har-in-air/STM32F411_USB_AUDIO_DAC/docs/dac_pcm5102a.png

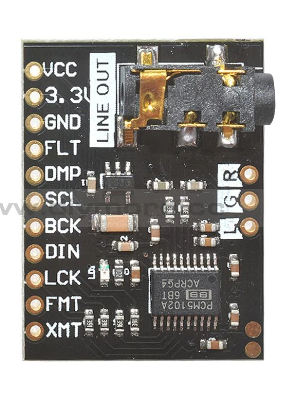
docs/dac_pcm5102a.png
