har-in-air/STM32F411_USB_AUDIO_DAC/docs/dac_uda1334ats.png

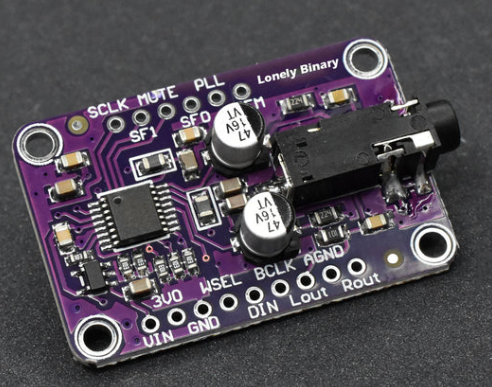
docs/dac_uda1334ats.png
