har-in-air/STM32F411_USB_AUDIO_DAC/(threads)

Thread 1 (2021-01-23):

Shematic BlackPill STM32F411 to PCM5102 Module

kloker2, 2021-01-23:
**BlackPill-F411         PCM5102 Module**
+5v                         VCC
NC                          3.3V
GND              |-       GND
GND              |-        FLT
GND              |-       DMP
GND              |-       SCL	I2Sx_MCK_PIN  (Master Clock)
B13 I2Sx_SCK_PIN  BCK	Тактовый сигнал битовой синхронизации (CLK)Bit clock or serial clock
B15 I2Sx_SD_PIN    DIN	Сигнал данных, который может передавать или принимать 2 разделённых по времени канала. (SD)
B12 I2Sx_WS_PIN   LCK	Тактовый сигнал фреймовой (по словам) синхронизации (WS word select)
GND              |-      FMT
B8  MUTE_PIN       XMT	Mute Software
_________________________________________
A6	I2Sx_MCK_PIN	NC (Master Clock)
_________________________________________
**Board Leds**
B3    LED_RED          // 96000
B6    LED_GREEN     // 48000
B9    LED_BLUE        // 44100

har-in-air, 2021-01-25:
Have updated the pinout in the README, thanks

Closed 2021-01-25.

Thread 2 (2021-05-02):

Error in interrupt table for STM32F411

robcazzaro, 2021-05-02:
First of all, thanks for sharing this. Really helpful

I ported your code to the Windows version of STM32IDE, and I noticed that every time I pushed the Black Pill KEY button, the code would hang in the following section of startup_stm32f411ceux.s

```
    .section  .text.Default_Handler,"ax",%progbits
Default_Handler:
Infinite_Loop:
  b  Infinite_Loop
  .size  Default_Handler, .-Default_Handler
```

I fixed the problem by making two changes in stm32f4xx_it.c

from

```
void EXTI1_IRQHandler(void)
{
  HAL_GPIO_EXTI_IRQHandler(GPIO_PIN_1);
}
```

to

```
void EXTI0_IRQHandler(void)
{
  HAL_GPIO_EXTI_IRQHandler(GPIO_PIN_0);
}
```

It looks like at some point, you changed the interrupt you used and the pin to trigger it, so the code was jumping to a non-existent IRQ service routine and trapped in the infinite loop handler

I would also suggest adding the following to the hardware connections, to explain how to generate the debug print in the USART2 output

```
A2                         TX       Serial debug
A3                         RX
GND                        GND
--------------------------------------------------------------------
To trigger debug printout (if enabled with DEBUG_FEEDBACK_ENDPOINT). press the KEY button on the Black Pill
```

[Not sure if it repros also with the STM32F401 project, I only compiled for STM32F411, but I think the same would happen for the STM32F401, too]

har-in-air, 2021-05-02:
Thanks, fix works on F401CCU6 board.

Closed 2021-05-02.

Thread 3 (2021-05-05):

Difficulty getting Make to compile

Jaron123, 2021-05-05:
Hello,

When trying to build the project I get:
"

make all
arm-none-eabi-gcc -c -mcpu=cortex-m4 -mthumb -mfpu=fpv4-sp-d16 -mfloat-abi=hard -DUSE_HAL_DRIVER -DUSE_FULL_ASSERT -DSTM32F401xC  -DDEBUG_FEEDBACK_ENDPOINT  -Iinc -Idrivers/STM32F4xx_HAL_Driver/Inc -Idrivers/STM32F4xx_HAL_Driver/Inc/Legacy -Istm32_usb/Core/Inc -Istm32_usb/Class/AUDIO/Inc -Idrivers/CMSIS/Device/ST/STM32F4xx/Include -Idrivers/CMSIS/Include -Idrivers/BSP -O2 -Wall -fdata-sections -ffunction-sections -MMD -MP -MF"build/main.d" -Wa,-a,-ad,-alms=build/main.lst src/main.c -o build/main.o
c:/st/stm32cubeide_1.6.0/stm32cubeide/plugins/com.st.stm32cube.ide.mcu.externaltools.make.win32_1.5.0.202011040924/tools/bin/sh: arm-none-eabi-gcc: not found
make: *** [Makefile:180: build/main.o] Error 127
"make all" terminated with exit code 2. Build might be incomplete.

"
I'm new to makefiles and compiling with STM32CubeIDE but so this might be inexperience but I'm at a loss of what to do.
Am I missing something? Is the project still ready to build?

har-in-air, 2021-05-05:
In the makefile, since GCC_PATH is not defined for you,  set GCC_PATH to the full windows path to the ST gcc compiler binary. Or you could add the path to the binary to your windows environment variable PATH.
    On Wednesday, 5 May, 2021, 03:05:02 pm IST, Jaron123 ***@***.***> wrote:

Hello,

When trying to build the project I get:
"

make all
arm-none-eabi-gcc -c -mcpu=cortex-m4 -mthumb -mfpu=fpv4-sp-d16 -mfloat-abi=hard -DUSE_HAL_DRIVER -DUSE_FULL_ASSERT -DSTM32F401xC -DDEBUG_FEEDBACK_ENDPOINT -Iinc -Idrivers/STM32F4xx_HAL_Driver/Inc -Idrivers/STM32F4xx_HAL_Driver/Inc/Legacy -Istm32_usb/Core/Inc -Istm32_usb/Class/AUDIO/Inc -Idrivers/CMSIS/Device/ST/STM32F4xx/Include -Idrivers/CMSIS/Include -Idrivers/BSP -O2 -Wall -fdata-sections -ffunction-sections -MMD -MP -MF"build/main.d" -Wa,-a,-ad,-alms=build/main.lst src/main.c -o build/main.o
c:/st/stm32cubeide_1.6.0/stm32cubeide/plugins/com.st.stm32cube.ide.mcu.externaltools.make.win32_1.5.0.202011040924/tools/bin/sh: arm-none-eabi-gcc: not found
make: *** [Makefile:180: build/main.o] Error 127
"make all" terminated with exit code 2. Build might be incomplete.

"
I'm new to makefiles and compiling with STM32CubeIDE but so this might be inexperience but I'm at a loss of what to do.
Am I missing something? Is the project still ready to build?

—
You are receiving this because you are subscribed to this thread.
Reply to this email directly, view it on GitHub, or unsubscribe.

Jaron123, 2021-05-06:
Thanks Hair in air!
If anyone has the same problem I copy and pasted the PATH variables (Project-properties-Enviroment) from another project into this one and that seemed to work.

FAUSTINOCRUZELIS, 2022-09-14:
> Thanks Hair in air! If anyone has the same problem I copy and pasted the PATH variables (Project-properties-Enviroment) from another project into this one and that seemed to work.

hello bro, i didn''t undestand how do you solved it
what software o binaries do you used to compile this on windows (i had to install ubutu and a lot of packets to make it compile jaja)

Closed 2021-05-06.

Thread 4 (2021-05-09):

How Can it use external clock in I2S

Timo-AL, 2021-05-09:
I want to use crystal oscillator as I2S clock source, but it woulden work.

I connect two oscillator to PA2 than connect led pins to enbale pin on oscillato. Also, changing some codes in bsp_audio.c. Than commenting out all the code in usart.c to left PA2 free. But the chip still use 25Mhz crystal as I2S clock source.

Here are codes that what I change.All of then are in bsp_audio.c.
```
const I2S_CLK_CONFIG I2S_Clk_Config24[3]  = {
{429, 4, 8, 0, 0x0B000000}, // 44.0995
{384, 5, 8, 0, 0x0C000000}, // 48.0000
{424, 3, 4, 0, 0x18000000}  // 96.0144
};
#endif
```
```
    if (freqindex != -1)  {
    N = I2S_Clk_Config24[freqindex].N;
    R = I2S_Clk_Config24[freqindex].R;
    I2SDIV = I2S_Clk_Config24[freqindex].I2SDIV;
    ODD = I2S_Clk_Config24[freqindex].ODD;

    RCC_ExCLKInitStruct.PeriphClockSelection** = RCC_I2SCLKSOURCE_EXT;
#ifdef STM32F411xE
    RCC_ExCLKInitStruct.PLLI2S.PLLI2SM = 25;
#endif
    RCC_ExCLKInitStruct.PLLI2S.PLLI2SN = N;
    RCC_ExCLKInitStruct.PLLI2S.PLLI2SR = R;
    HAL_RCCEx_PeriphCLKConfig(&RCC_ExCLKInitStruct);
    I2S_PR = (MCKOE<<9) | (ODD<<8) | I2SDIV;
    I2S_Config_I2SPR(I2S_PR);
    }
  else { // Default PLL I2S configuration for 96000 Hz 24bit
    N = I2S_Clk_Config24[2].N;
    R = I2S_Clk_Config24[2].R;
    I2SDIV = I2S_Clk_Config24[2].I2SDIV;
    ODD = I2S_Clk_Config24[2].ODD;

    RCC_ExCLKInitStruct.PeriphClockSelection = RCC_I2SCLKSOURCE_EXT;
#ifdef STM32F411xE
    RCC_ExCLKInitStruct.PLLI2S.PLLI2SM = 25;
#endif
    RCC_ExCLKInitStruct.PLLI2S.PLLI2SN = N;
    RCC_ExCLKInitStruct.PLLI2S.PLLI2SR = R;
    HAL_RCCEx_PeriphCLKConfig(&RCC_ExCLKInitStruct);
    I2S_PR = (MCKOE<<9) | (ODD<<8) | I2SDIV;
    I2S_Config_I2SPR(I2S_PR);
```
```
static void I2Sx_Init(uint32_t AudioFreq) {
  haudio_i2s.Instance = SPI2;

  __HAL_I2S_DISABLE(&haudio_i2s);

  haudio_i2s.Init.Mode = I2S_MODE_MASTER_TX;
  haudio_i2s.Init.Standard = I2S_STANDARD_PHILIPS;
  haudio_i2s.Init.DataFormat = I2S_DATAFORMAT_24B;
  haudio_i2s.Init.AudioFreq = AudioFreq;
  haudio_i2s.Init.CPOL = I2S_CPOL_LOW;
  haudio_i2s.Init.ClockSource = I2S_CLOCK_EXTERNAL;
#ifdef USE_MCLK_OUT
  haudio_i2s.Init.MCLKOutput = I2S_MCLKOUTPUT_ENABLE;
#endif
  haudio_i2s.Init.FullDuplexMode = I2S_FULLDUPLEXMODE_DISABLE;

  HAL_I2S_Init(&haudio_i2s);
}
```

har-in-air, 2021-05-09:
sorry, no idea how that would work.

Closed 2021-05-09.

Thread 5 (2021-05-14):

Problem with compiling

gotrune, 2021-05-14:
Hello,
I'm on windows with cubeIDE v1.6.1 and I cant compile due to librairies error, i want to try asap if this board is good for me then can you upload a compiled program for the stm32f401CU please?

har-in-air, 2021-05-14:
??!!  What is the library error ? What is "this board" ? You have provided zero information that points to an issue with the repository code that I need to fix.

gotrune, 2021-05-14:
I dont have any link for the library's in the project. It's my first time on CubeIDE.
I think there's no issue with your code, i'm a beginner with cube and i dont want to spend more time on its. My test board is a Blackpill STM32F401CCU6, I just want a compiled file please.
If the project work good for my purpose i'll gop further with the debug....

Closed 2021-05-14.

Thread 6 (2021-05-16):

Help troubleshooting, please

robcazzaro, 2021-05-16:
I'm using a Windows 7 PC connected to a BlackPill STM32F411 with your code running on it. Everything works

From time to time, though. I get the onboard blue LED (PC13) to turn on, flashing rapidly. The code that triggers it is in usb_audio.c, in particular:

```
    // Monitor remaining writable buffer samples with LED
    if (audio_buf_writable_samples < AUDIO_BUF_SAFEZONE_SAMPLES) {
    	BSP_OnboardLED_On();
    	}
    else {
    	BSP_OnboardLED_Off();
    	}
```

I'm trying to understand if that's something I need to worry about and, if so, what can I look at to try and figure out if I did something wrong (I'm compiling on a Windows machine and using a STM32CubeIDE project I created, so there might be some difference with your code)

har-in-air, 2021-05-17:
If the led is flashing on and off regularly and the audio application is not working, it's in the Error_Handler in main.c - which means a fatal fault. I haven't seen that yet, you can try putting a breakpoint in the entry and trace the call leading to the fault.

If the blue led comes on while no audio is streaming, and then immediately goes off when you start streaming audio, no problem.

robcazzaro, 2021-05-17:
Thanks for your reply. I should have mentioned, but I already had a breakpoint in the Error_Handler function, and that never gets triggered.

In my case the blue led turns on and off while streaming. The BSP_OnboardLED_On(0 and BSP_OnboardLED_Off() functions sometimes get called multiple times while streaming, so I can see the LED flickering.

Am I right in understanding that the LED flickering while streaming might indicate a buffer underrun? I wonder if it's a problem with the USB bus on my Windows machine being overloaded and maxing out, since it seems to happen more frequently when the PC is overloaded

har-in-air, 2021-05-18:
Thats possible. Do you have heavy data transfers on USB e.g. external hard drives - that could cause an issue with available bus bandwidth for isochronous transfers. I have two USB hubs attached to my laptop with several HID devices attached,  JTAG adapter for flashing, printer etc.

I have only seen a hiccup in the audio streaming a couple times in several months now.  I do see the onboard led come on and stay on sometimes when no audio is streaming, but it goes off immediately when playback starts.

Closed 2021-05-17.

Thread 7 (2021-05-16):

Are you interested in adding the files to make your project work in STM32CubeIDE on Windows?

robcazzaro, 2021-05-16:
I ported your project to STM32CubeIDE on Windows, and if you are interested, I have included here all the files (for STM32F411, if you also want for the 401 I will need to tweak a couple of things)

[STM32F411UAD.zip](https://github.com/har-in-air/STM32F411_USB_AUDIO_DAC/files/6490113/STM32F411UAD.zip)

har-in-air, 2021-05-17:
Thanks

Closed 2021-05-17.

Thread 8 (2021-05-16):

Feature request: volume control

robcazzaro, 2021-05-16:
I really like the code you wrote, and I plan to use it in the future. I'm connecting my STM32F411 BlackPill to a SSM3582 amplifier board that takes I2S input directly and amplifies it (i.e. not just a I2S DAC like the PCM5102a)

Unfortunately, since the amplifier is 30W and has no volume control, without the ability to change the volume, it will always output at the maximum volume. Your code currently only uses volume=0 for mute and volume=100 for full volume, with nothing in between.

Would you consider adding code to actually enable volume control, possibly using some of the ideas in this thread https://www.microchip.com/forums/m932509.aspx?

har-in-air, 2021-05-17:
Thanks, an additional control endpoint for volume is possible but no promises as to when and if I will implement this.
I just use the host application volume control.

In another project where I use a TAS5753 I2S amplifier, it has an I2C configuration & control interface  with volume and mute control, and I use a rotary encoder for volume control.
If you're talkiing about a similar interface but where I manually scale the I2S data using a button or encoder interface,  that's not something I personally want to add to this project as I prefer  a minimalistic USB-I2S dongle.

har-in-air, 2021-05-17:
BTW, the SSM3582 has an I2C interface, you can add the volume control feature yourself using my STM32F407 USB Audio + FPGA audiocrossover filter + I2S amplifier project as an example

robcazzaro, 2021-05-18:
Thanks. Unfortunately my SSM board does not expose the I2C connection, and doesn't have a volume control. So my only way to change volume is to use the Windows volume control and have Windows send "scaled down" audio. And for some reason it doesn't do it with your code, but works with other USB devices with no volume control.

I think it is connected to how Windows sees the device capabilities. I basically need Windows to recognize the device and uses the following https://docs.microsoft.com/en-us/windows-hardware/drivers/audio/software-volume-control-support

I'm now trying to understand from the USB audio descriptor is there's anything I can do to have Windows behave properly and send scaled down data

Can you actually change volume from your computer? I assume you are running Linux

har-in-air, 2021-05-18:
Yes, I use Ubuntu - VLC, youtube, web video apps with volume controls all work  fine. Only thing that doesn't is the volume control icon on my desktop title bar :-P.

The host apps should see the device enumerated capabilities and either send a control transfer for volume if supported, or scale the data if not supported, like VLC etc are doing. I guess not all support the data scaling option.

robcazzaro, 2021-05-18:
Thanks for confirming, that's what I thought. Even in your case, it's not working properly: if the system volume control doesn't work, that means that the OS thinks that the device will implement its own volume scaling (either in SW or HW, for example with a I2C volume controller). The apps, on the other hand, scale the output internally, before sending it to the OS pipeline. So, obviously, if an app is reducing the volume, the OS itself sees a lower signal and sends a lower signal to the I2S device.

I finally figured out what was happening. In your code, you declared that the USB device has both a Mute and Volume functionality, but then did not implement the volume control itself, just Mute On if Volume==0, or Mute Off for every other value. So basically, every time you change the OS volume, the OS  simply sends a request to the USB endpoint to use a new volume during playback, but then the code didn't do anything with that request.

So the fix is really trivial, simply tell the OS that the device doesn't have a volume control, by removing the |AUDIO_CONTROL_VOL setting in AUDIO_CONTROL_FEATURES as below (line 48 in usb_audio.c)

```
// Feature Unit Config
#define AUDIO_CONTROL_FEATURES (AUDIO_CONTROL_MUTE )
```

Hardware Mute control in BSP_AUDIO_OUT_SetMute() still works just fine, as well as the HW mute when nothing is playing. On the other hand, BSP_AUDIO_OUT_SetVolume() is never called, so setting the volume to 0 in the OS control will produce no sound (OS scaling the stream to 0), but will not enable the hardware Mute pin. So the only proper way to set a hardware Mute is by using the OS mute functionality

har-in-air, 2021-05-19:
Just removing AUDIO_CONTROL_VOLUME  from AUDIO_CONTROL_FEATURES broke the code (no audio anymore) on my system.

But thanks for pushing this issue, I am working on usb audio mute and volume  control implementation, will update when done.

har-in-air, 2021-05-19:
Implemented USB volume and mute feature. Max volume = 0dB (no amplification), Min volume = -126dB, attenuation steps in 6dB. Now mute and volume control work with VLC as well as Ubuntu desktop volume control. Let me know if you see any issues on Windows.

robcazzaro, 2021-05-19:
I just tested your new code, it works well in Windows, too.

Please keep in mind that on my laptop (Win 7, a few years old), the device keeps flashing the blue LED every time the processor is even a bit more loaded than just background (i.e. window switching). It makes it unusable in practice (every time the blue LED flashes, the audio stream emits a buzz, whose frequency depends on the encoding frequency: 44.1, 48 or 96 KHz)

The same laptop can stream all day to another USB device (Topping MX3) at 96KHz without ever having audible problems. I think that the buffer size you are using might be a bit too small, and too prone to USB data fluctuations. So the STM32 is data starved every time there is an even minor stream problem. Probably Windows is more issue prone than Linux to these problems. I'll see if I can do something about it, and open a new issue with suggestions in that case.

Thanks for all your work and for sharing it

har-in-air, 2021-05-20:
There is a tradeoff with larger buffers - more latency, which becomes an issue with syncing video and audio playback. Anyway, try increasing the buffer size and see if that helps.

har-in-air, 2021-05-21:
FYI, updated the volume control feature to use 3dB attenuation steps from 0dB  (max) to -96dB (min)

Closed 2021-05-20.

Thread 9 (2021-05-18):

Minor: the device appears as USB 2.0 capable, when it's only USB 1.1

robcazzaro, 2021-05-18:
This is a common problem with the STM32 USB libraries provided by ST. They define the device as USB 2.0 capable, even when the device itself is only capable of speeds up to 12Mbps, not 480Mbps. In most cases it's harmless, but some USB utilities like USB Tree View (https://www.uwe-sieber.de/usbtreeview_e.html) flag the problem. If the device were really USB 2.0 capable, it would be possible to implement even higher encoding speeds (i.e. 384KHz), but that's not an option with the BlackPill F4x1 which would require a different physical interface for USB OTG HS

In case you want to fix it, it's a simple change in usb_desc.c, lines 89 and 90 (bcdUSB high and low byte)

```
/* USB Standard Device Descriptor */
#if defined ( __ICCARM__ ) /*!< IAR Compiler */
  #pragma data_alignment=4
#endif
__ALIGN_BEGIN   uint8_t USBD_DeviceDesc[USB_LEN_DEV_DESC] __ALIGN_END = {
  0x12,                       /* bLength */
  USB_DESC_TYPE_DEVICE,       /* bDescriptorType */
  0x10,                       /* bcdUSB */      // was 0x00
  0x01,                                                  // was 0x02
  0x00,                       /* bDeviceClass */
  0x00,                       /* bDeviceSubClass */
  0x00,                       /* bDeviceProtocol */
  USB_MAX_EP0_SIZE,           /* bMaxPacketSize */
  LOBYTE(USBD_VID),           /* idVendor */
  HIBYTE(USBD_VID),           /* idVendor */
  LOBYTE(USBD_PID),           /* idVendor */
  HIBYTE(USBD_PID),           /* idVendor */
  0x00,                       /* bcdDevice rel. 2.00 */
  0x02,
  USBD_IDX_MFC_STR,           /* Index of manufacturer string */
  USBD_IDX_PRODUCT_STR,       /* Index of product string */
  USBD_IDX_SERIAL_STR,        /* Index of serial number string */
  USBD_MAX_NUM_CONFIGURATION  /* bNumConfigurations */
}; /* USB_DeviceDescriptor */
```

har-in-air, 2021-05-19:
Thanks, fixed !

har-in-air, 2021-06-10:
Changed back to v2.0, STM32 usb library examples are correct - there is no issue with supporting only FS interface and being compliant with v2.0.

Closed 2021-05-19.

Thread 10 (2021-05-20):

Using other DACs

radiomanoff, 2021-05-20:
Thanks for the project. STM32F401CCU6 + PCM5102 bundle worked without problems under Linux Mint
Using other DACs with MCLK (Master Clock) support?
Is the pin turned on - MCLK (Master Clock)?

har-in-air, 2021-05-21:
Look at the makefile, enable USE_MCLK_OUT
```
# C definesC_DEFS =  \-DUSE_HAL_DRIVER \-DUSE_FULL_ASSERT \-D$(CPU_DEF) \-DDEBUG_FEEDBACK_ENDPOINT # -DUSE_MCLK_OUT
```

radiomanoff, 2021-05-23:
Thank you. But unfortunately STM32F401CCU6 does not support master clock
[https://radiomanoff.at.ua/_ph/1/383999272.png](url)

har-in-air, 2021-05-24:
Thanks, fixed conditional compilation for MCLK output and corrected the readme

Closed 2021-05-21.

Thread 11 (2022-09-14):

Multiple prototypes (3 units) does works (at sametime) conected in the same hub usb.

FAUSTINOCRUZELIS, 2022-09-14:
hello bro. My name is Fausto and i'm mexican geek of the tecnology and sound systems in general.
I'm trying to develop and little system for power an sound system of 3 ways (bass, middle and high) in my bedroom.
i would like to conect 3 boards (stm32f411... and as i2s-analog bridge i used an pcm5102) in a same device to make easy the setup of my sound system.  To do this i was trying to use some usb hubs , my laptop recognize correctly to these but when i try to use at the sametime only one works and if i try to force to work the others 2 boards, all board go fuck and i must to disconnect the hub to stop the distortion that my action causes (with Carla and pipewire funtion on a fedora linux system), simplify its do not work. I have been thinking that the hub usb cannot give the suficient power to turn all the 3 boards at the sametamie but i made an custom hub usb with an alliexpress' board and external power supply but it did the same behaviour.  now i think that the problem is that the code that you provide (i am very grateful with you and i would like to give you a little reward/payment by your work), gives the same device name and ID (obteined with lsusb to list usb devices and its ports) i think that if i chenge the name and id gived in your code i could use them at the same time correctly. Can you say me the segment from your code were i can change the name and ID (or another parameter to diferential the boards amoung its).

When i was doing research on internet and i found yoy proyect i planteated this (img) where i'm trying to reduce cost and parts.
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

I use it as part of an improviced digital sound proccesor on carla (falkXstudio's linux software) and then crossover the signals to the dacs usb. (img of my segond brobe after try with a comercial hub usb)
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

Greetings and blessings for you.
PD: do you know and alternative to use the stm32f411... as a ADC input for conect an microphone to pc by usb?

har-in-air, 2022-09-14:
On Windows, the device instance ID is dependent on the descriptor bytes as well as the port it is connected to, so each device should have a different instance ID when they are  plugged in at the same time.
is the USB Instance ID on Windows unique for a device?

|
|
|
|  |  |

 |

 |
|
|  |
is the USB Instance ID on Windows unique for a device?

I'm trying to identify a USB device uniquely on a Windows system. Since serial number is optional (and empty on ...
 |

 |

 |

    On Wednesday, 14 September, 2022 at 12:47:45 pm IST, FAUSTINOCRUZELIS ***@***.***> wrote:

hello bro. My name is Fausto and i'm mexican geek of the tecnology and sound systems in general.
I'm trying to develop and little system for power an sound system of 3 ways (bass, middle and high) in my bedroom.
i would like to conect 3 boards (stm32f411... and as i2s-analog bridge i used an pcm5102) in a same device to make easy the setup of my sound system. To do this i was trying to use some usb hubs , my laptop recognize correctly to these but when i try to use at the sametime only one works and if i try to force to work the others 2 boards, all board go fuck and i must to disconnect the hub to stop the distortion that my action causes (with Carla and pipewire funtion on a fedora linux system), simplify its do not work. I have been thinking that the hub usb cannot give the suficient power to turn all the 3 boards at the sametamie but i made an custom hub usb with an alliexpress' board and external power supply but it did the same behaviour. now i think that the problem is that the code that you provide (i am very grateful with you and i would like to give you a little reward/payment by your work), gives the same device name and ID (obteined with lsusb to list usb devices and its ports) i think that if i chenge the name and id gived in your code i could use them at the same time correctly. Can you say me the segment from your code were i can change the name and ID (or another parameter to diferential the boards amoung its).

When i was doing research on internet and i found yoy proyect i planteated this (img) where i'm trying to reduce cost and parts.

I use it as part of an improviced digital sound proccesor on carla (falkXstudio's linux software) and then crossover the signals to the dacs usb. (img of my segond brobe after try with a comercial hub usb)

Greetings and blessings for you.
PD: do you know and alternative to use the stm32f411... as a ADC input for conect an microphone to pc by usb?

—
Reply to this email directly, view it on GitHub, or unsubscribe.
You are receiving this because you are subscribed to this thread.Message ID: ***@***.***>

FAUSTINOCRUZELIS, 2022-09-16:
hello i didnt probe this on windows, i only want to make it work on linux.
but i want to set an unique USB Instance ID to each board but i dont know how to do it.

image below is the usb and audio devices listed on device manager on win11.  but with lsusb on windows, the info provided by linux is that apparently the 3 boards have the same id and name (and when i try to use all. )
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

> On Windows, the device instance ID is dependent on the descriptor bytes as well as the port it is connected to, so each device should have a different instance ID when they are  plugged in at the same time. is the USB Instance ID on Windows unique for a device? | | | | | | | | | | | is the USB Instance ID on Windows unique for a device? I'm trying to identify a USB device uniquely on a Windows system. Since serial number is optional (and empty on ... | | | On Wednesday, 14 September, 2022 at 12:47:45 pm IST, FAUSTINOCRUZELIS ***@***.***> wrote: hello bro. My name is Fausto and i'm mexican geek of the tecnology and sound systems in general. I'm trying to develop and little system for power an sound system of 3 ways (bass, middle and high) in my bedroom. i would like to conect 3 boards (stm32f411... and as i2s-analog bridge i used an pcm5102) in a same device to make easy the setup of my sound system. To do this i was trying to use some usb hubs , my laptop recognize correctly to these but when i try to use at the sametime only one works and if i try to force to work the others 2 boards, all board go fuck and i must to disconnect the hub to stop the distortion that my action causes (with Carla and pipewire funtion on a fedora linux system), simplify its do not work. I have been thinking that the hub usb cannot give the suficient power to turn all the 3 boards at the sametamie but i made an custom hub usb with an alliexpress' board and external power supply but it did the same behaviour. now i think that the problem is that the code that you provide (i am very grateful with you and i would like to give you a little reward/payment by your work), gives the same device name and ID (obteined with lsusb to list usb devices and its ports) i think that if i chenge the name and id gived in your code i could use them at the same time correctly. Can you say me the segment from your code were i can change the name and ID (or another parameter to diferential the boards amoung its). When i was doing research on internet and i found yoy proyect i planteated this (img) where i'm trying to reduce cost and parts. I use it as part of an improviced digital sound proccesor on carla (falkXstudio's linux software) and then crossover the signals to the dacs usb. (img of my segond brobe after try with a comercial hub usb) Greetings and blessings for you. PD: do you know and alternative to use the stm32f411... as a ADC input for conect an microphone to pc by usb? — Reply to this email directly, view it on GitHub, or unsubscribe. You are receiving this because you are subscribed to this thread.Message ID: ***@***.***>

har-in-air, 2022-09-16:
If you only want to change the serial number, that is in inc/usb_desc.h - you can modify ID3.
You can also try changing the PID ( I used a random value for PID, the vendor ID is one reserved for prototypes) in  src/usbd_desc.c
    On Friday, 16 September, 2022 at 10:51:56 am IST, FAUSTINOCRUZELIS ***@***.***> wrote:

hello i didnt probe this on windows, i only want to make it work on linux.
but i want to set an unique USB Instance ID to each board but i dont know how to do it.

image below is the usb and audio devices listed on device manager on win11. but with lsusb on windows, the info provided by linux is that apparently the 3 boards have the same id and name (and when i try to use all. )

On Windows, the device instance ID is dependent on the descriptor bytes as well as the port it is connected to, so each device should have a different instance ID when they are  plugged in at the same time. is the USB Instance ID on Windows unique for a device? | | | | | | | | | | | is the USB Instance ID on Windows unique for a device? I'm trying to identify a USB device uniquely on a Windows system. Since serial number is optional (and empty on ... | | | On Wednesday, 14 September, 2022 at 12:47:45 pm IST, FAUSTINOCRUZELIS @.> wrote: hello bro. My name is Fausto and i'm mexican geek of the tecnology and sound systems in general. I'm trying to develop and little system for power an sound system of 3 ways (bass, middle and high) in my bedroom. i would like to conect 3 boards (stm32f411... and as i2s-analog bridge i used an pcm5102) in a same device to make easy the setup of my sound system. To do this i was trying to use some usb hubs , my laptop recognize correctly to these but when i try to use at the sametime only one works and if i try to force to work the others 2 boards, all board go fuck and i must to disconnect the hub to stop the distortion that my action causes (with Carla and pipewire funtion on a fedora linux system), simplify its do not work. I have been thinking that the hub usb cannot give the suficient power to turn all the 3 boards at the sametamie but i made an custom hub usb with an alliexpress' board and external power supply but it did the same behaviour. now i think that the problem is that the code that you provide (i am very grateful with you and i would like to give you a little reward/payment by your work), gives the same device name and ID (obteined with lsusb to list usb devices and its ports) i think that if i chenge the name and id gived in your code i could use them at the same time correctly. Can you say me the segment from your code were i can change the name and ID (or another parameter to diferential the boards amoung its). When i was doing research on internet and i found yoy proyect i planteated this (img) where i'm trying to reduce cost and parts. I use it as part of an improviced digital sound proccesor on carla (falkXstudio's linux software) and then crossover the signals to the dacs usb. (img of my segond brobe after try with a comercial hub usb) Greetings and blessings for you. PD: do you know and alternative to use the stm32f411... as a ADC input for conect an microphone to pc by usb? — Reply to this email directly, view it on GitHub, or unsubscribe. You are receiving this because you are subscribed to this thread.Message ID: @.>

—
Reply to this email directly, view it on GitHub, or unsubscribe.
You are receiving this because you commented.Message ID: ***@***.***>

FAUSTINOCRUZELIS, 2022-09-17:
i could to change the ids of each board but when i am trying to connecte all at the same hub usb nothing work, only lsubs list them but it linux (pipewire)
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

but it can't to play audio, it only works when each board is connected to a dedicate usb (1 usb port from laptop for 1 usb dac board) and don't  works connected into the same (bougth on a shop) usb hub
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
the image up is went 2 boards are plugged on diferent usb ports, and the two works normaly.

other caracterist is that, when i plug only one boarn into the hub usb board i works, and then when i plug other board into the same hub, lsusb list both of them correctly but only the first board that was plug, works and the other board don't.

Thanks bro for your aswers, whenever i can, i going to write an little doc to resume how to implement multiple usb dacs on the same hub usb

FAUSTINOCRUZELIS, 2022-11-05:
I concluded that the issue is in the way what  USB works. And i don't know If the code implementents the USB audio compilant 2, the issue could be sorted.

Closed 2022-11-05.

Thread 13 (2022-11-25):

An little contribution to make easy the implementation of your code

FAUSTINOCRUZELIS, 2022-11-25:
[Drive link to Gerber file of My prototype PCB design](https://drive.google.com/file/d/16NNwvrwQJbw5402ePAMmbVkY0LZwi2i0/view?usp=drivesdk)

DeflateAwning, 2023-12-24:
@FAUSTINOCRUZELIS, it would be awesome if you could put this in a GitHub repo, ideally with the source design files (from whatever software you used to make it), and the Gerber in a "Release".

I'm considering doing something similar, and would love to take a look at what you made!

Also, the Google Drive link is now broken.

Closed 2024-08-21.

Thread 14 (2023-03-14):

Playing does not start reliably

elagil, 2023-03-14:
Hello,

firstly, thanks a lot for your project. It fixes lots of issues with the ST-provided reference implementation.

I ported the functionality of your code into a fresh CubeMX project and got it playing correctly - the SOF mechanism works great.
However, playing does not start reliably, after stopping previously.

I noticed that - when that happens - I run into the `USBD_AUDIO_IsoOutIncomplete()` callback. Then, `USBD_AUDIO_DataOut()` is never reached again.

My assumption is that when hitting `USBD_AUDIO_IsoOutIncomplete()`, a previous receive failed. So, I assume that I need to `USBD_LL_PrepareReceive()` again, so that reception can restart successfully.

My solution looks as follows:

```C
static uint8_t USBD_AUDIO_IsoOutIncomplete(USBD_HandleTypeDef *pdev, uint8_t epnum)
{
  UNUSED(epnum);

  USBD_AUDIO_HandleTypeDef *haudio;
  haudio = (USBD_AUDIO_HandleTypeDef *)pdev->pClassDataCmsit[pdev->classId];

  // Flush, just to be safe.
  USBD_LL_FlushEP(pdev, AUDIO_OUT_EP);

  // Prepare Out endpoint to receive first/next audio packet
  (void)USBD_LL_PrepareReceive(pdev, AUDIOOutEpAdd,
                                &haudio->buffer[haudio->wr_ptr],
                                AUDIO_OUT_PACKET);

  return (uint8_t)USBD_OK;
}
```

Have you encountered similar issues? The above fixes it for me. I never have problems restarting audio playback.

har-in-air, 2023-03-15:
Thanks, that's interesting. I'm not sure I've encountered this and I use the USBDAC as an every day headphone driver - it's plugged in right now.Are you saying you used CubeMX to install  the required libraries as well ? I based mine on the DragonMan Makefile based project and made sure once I had a working set of libraries that they were untouched. That's the reason forstaying with the Makefile based project and a non-standard directory structure.  
But if you can get it working with CubeIDE and CubeMX you should publish it and send me a link that I can add to the README. I'm sure a lot of people would prefer using an up to date CubeIDE/CubeMX build environment.  
Its been a while since I had a working STM development environment on my laptop.  I will update my code with your IsOutIncomplete callback  once I can build and test it. In the meantime if you or anyone else can verify this is compatible with the Makefile project source, let me know.    On Wednesday, 15 March, 2023 at 03:14:44 am IST, Adrian ***@***.***> wrote:

Hello,

firstly, thanks a lot for your project. It fixes lots of issues with the ST-provided reference implementation.

I ported the functionality of your code into a fresh CubeMX project and got it playing correctly - the SOF mechanism works great.
However, playing does not start reliably, after stopping previously.

I noticed that - when that happens - I run into the USBD_AUDIO_IsoOutIncomplete callback. Then, USBD_AUDIO_DataOut is never reached again.

It seems to me like, when hitting USBD_AUDIO_IsoOutIncomplete, a previous receive failed. So, I assume that I need to USBD_LL_PrepareReceive again in that case.

My solution looks as follows:
static uint8_t USBD_AUDIO_IsoOutIncomplete(USBD_HandleTypeDef *pdev, uint8_t epnum)
{
  UNUSED(epnum);

  USBD_AUDIO_HandleTypeDef *haudio;
  haudio = (USBD_AUDIO_HandleTypeDef *)pdev->pClassDataCmsit[pdev->classId];

  USBD_LL_FlushEP(pdev, AUDIO_OUT_EP);

  /* Prepare Out endpoint to receive next audio packet */
  (void)USBD_LL_PrepareReceive(pdev, AUDIOOutEpAdd,
                                &haudio->buffer[haudio->wr_ptr],
                                AUDIO_OUT_PACKET);

  return (uint8_t)USBD_OK;
}
Have you encountered similar issues? The above fixes it for me. I never have problems restarting audio playback.

—
Reply to this email directly, view it on GitHub, or unsubscribe.
You are receiving this because you are subscribed to this thread.Message ID: ***@***.***>

elagil, 2023-03-15:
> Are you saying you used CubeMX to install  the required libraries as well ?

Yes, that's right! I only edited the minimum amount of files for enabling audio playback. In fact, I only had to add the `usbd_audio` module and kept the rest of the generated files for a USB Audio device.

However, I currently have a reduced feature set, because I don't need the extended functionality (only 16 bit/48 kHz, no volume control), as my DSP/amplifiers run at a fixed 48 kHz. I will create and share a template project, when I am finished.

har-in-air, 2023-03-15:
OK. Are you using Windows ? I have only been using the USB DAC on my Android phone and my Ubuntu laptop. Tested it  once on Windows 10 just to check. I will add your IsOutIncomplete callback. 
    On Wednesday, 15 March, 2023 at 01:21:40 pm IST, Adrian ***@***.***> wrote:

Are you saying you used CubeMX to install the required libraries as well ?

Yes, that's right! I only edited the minimum amount of files for enabling audio playback. In fact, I only had to add the usbd_audio module and kept the rest of the generated files for a USB Audio device.

However, I currently have a reduced feature set, because I don't need the extended functionality (only 16 bit/48 kHz, no volume control), as my DSP/amplifiers run at a fixed 48 kHz. I will create and share a template project, when I am finished.

—
Reply to this email directly, view it on GitHub, or unsubscribe.
You are receiving this because you commented.Message ID: ***@***.***>

elagil, 2023-03-15:
Yes, I use Windows 11. Could be related to it, since this is essentially a fix for a host issue.

har-in-air, 2023-03-17:
Added suggested fix

elagil, 2023-03-27:
After two weeks of struggle, I still failed to get the current ST driver to send out my feedback value to the PC. It might be broken, as forum posts suggest.

I switched to the amazing ChibiOS HAL and RTOS, and implemented the functionality on that basis.
Find it here: https://github.com/elagil/usb-i2s-bridge

Documentation and functionality are not completely finished, but usable.

har-in-air, 2023-03-28:
I was toying with the idea of migrating the project to an STM32CubeIDE project using the latest HAL libraries, and am now glad I stayed with a working snapshot of the library sources at the time.

elagil, 2023-03-28:
I think that was a wise choice! ST also no longer includes any audio demo projects that I could find - so I assumed that they never test for it.

Closed 2023-03-17.

Thread 15 (2023-03-18):

Can you make it work with alc883(TDM codec)?

Raduq91, 2023-03-18:
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
datasheet:
[alc883.pdf](https://github.com/har-in-air/STM32F411_USB_AUDIO_DAC/files/11008833/alc883.pdf)

har-in-air, 2023-03-19:
This is not an issue, closed

Closed 2023-03-19.

Thread 16 (2023-04-24):

is there an easy way to add an ADC

OwnGamesGamer, 2023-04-24:
I would want to have an ADC and a DAC connected to this to recors and play audio on my pc. would that be possible with this or with small modifications?

har-in-air, 2023-04-24:
You can search for this in the stm32 official code repository 

Sent from Yahoo Mail on Android

  On Mon, 24 Apr 2023 at 16:40, ***@***.***> wrote:

I would want to have an ADC and a DAC connected to this to recors and play audio on my pc. would that be possible with this or with small modifications?

—
Reply to this email directly, view it on GitHub, or unsubscribe.
You are receiving this because you are subscribed to this thread.Message ID: ***@***.***>

DeflateAwning, 2023-12-25:
It looks like at least one fork has gotten an ADC working:
* https://github.com/mcginty/wombo_old

Not sure how well it works, but just wanted to share that I found it.

Closed 2024-08-21.

Thread 17 (2023-06-10):

Buzzing

islcom, 2023-06-10:
Hi,
Running Cantata to access MPD music server, working fine but when crossfade is enabled there is a buzzing sound for the duration of the crossfade. Running debian with alsa and aslaequal.

Thanks for the excellent project.

islcom, 2023-06-11:
Same buzzing (to a lesser extent) on the internal sound card.
Will have to look elsewhere, maybe the power supply.

Thanks

Closed 2023-06-11.

Thread 18 (2023-11-17):

Not compiling

smagtech, 2023-11-17:
I'm getting this error. I'm new with  stm32cubeide. and their is no file call .ioc in your STM32F411_USB_AUDIO_DAC-main file. Please help.
if step by step guide will be more helpful.

 STM32CubeIDE
Version: 1.13.2

error is....

17:56:38 **** Incremental Build of configuration Default for project ok4 ****
make all
Cannot run program "make": Launching failed

Error: Program "make" not found in PATH
PATH=[C:/ST/STM32CubeIDE_1.13.2/STM32CubeIDE//plugins/com.st.stm32cube.ide.jre.win64_3.0.0.202305091045/jre/bin/server;C:/ST/STM32CubeIDE_1.13.2/STM32CubeIDE//plugins/com.st.stm32cube.ide.jre.win64_3.0.0.202305091045/jre/bin;C:\Program Files (x86)\Common Files\Oracle\Java\javapath;C:\WINDOWS\system32;C:\WINDOWS;C:\WINDOWS\System32\Wbem;C:\WINDOWS\System32\WindowsPowerShell\v1.0\;C:\WINDOWS\System32\OpenSSH\;C:\Program Files\PuTTY\;C:\Program Files (x86)\Cypress\EZ-USB FX3 SDK\1.3\util\elf2img\;C:\Program Files\Git\cmd;C:\Users\G_Sudhir\AppData\Local\Microsoft\WindowsApps;;C:\Users\G_Sudhir\AppData\Local\Programs\Microsoft VS Code\bin;C:\ST\STM32CubeIDE_1.13.2\STM32CubeIDE]

17:56:38 Build Failed. 1 errors, 0 warnings. (took 70ms)

har-in-air, 2023-11-18:
I'm sorry that you mistook a public Github code repository for an instructables project.
Try using google with the search "stm32cubeide make not found in path".

Hint : this is a makefile project, that is clearly specified in the introduction. You don't even need an IDE. You just need the toolchain and path correctly set for all the binaries. You can build and flash directly from the command line. If you want to use Stm32CubeIDE, google "Stm32CubeIDE makefile project".  I face multiple similar issues in every project, but I look for solutions on Google  before behaving like an entitled spoon-fed infant.

You could have simply done this,  and then posted an issue where you mentioned that you faced this problem and one sentence  where you explained what was required with any links to webpages etc.  That would have been a productive contribution to the open source community, even if I closed the issue without responding.

As an example of being productive, someone got irritated that I didn't include a schematic. He sent me an email and included a text table with the pin connections. I rewrote that with more information and included it in the README.

smagtech, 2023-11-19:
finely made it run working fine.

thank you for advise .

Closed 2023-11-18.

Thread 20 (2023-12-25):

What is the latency on this project? Can you please add it to the README?

DeflateAwning, 2023-12-25:
This project appears incredibly impressive!

I'm interested in knowing the overall latency and whether you've conducted any measurements. Adding this information to the README would be valuable for potential builders, especially for applications like games and voice calls that thrive on low latency. Confirming that it's <10ms would provide useful assurance.

When I eventually undertake the build, I'll certainly include this stat in the project documentation, if you haven't done so already

har-in-air, 2023-12-25:
Done

DeflateAwning, 2023-12-25:
I missed the note in the README. Here's what I've worked out; let me know if you see any mistakes:

> A single stereo sample uses 2x3 = 6 bytes. The estimated latency in seconds is((AUDIO_TOTAL_BUF_SIZE/2) / 6) * (1/sample_freq_hz)

```
// per stm32_usb/Class/AUDIO/Inc/usbd_audio.h:
USBD_AUDIO_FREQ_MAX = 96000
AUDIO_OUT_PACKET_NUM = 8
AUDIO_TOTAL_BUF_SIZE = ((uint16_t)((USBD_AUDIO_FREQ_MAX / 1000U + 1) * 2U * 3U * AUDIO_OUT_PACKET_NUM))
                     = (96000 / 1000 + 1) * 2U * 3U * 8)) = 4656

sample_freq_hz = 44100 // not sure if this should be 44100, or 96000

estimated latency in seconds is: = ((AUDIO_TOTAL_BUF_SIZE/2) / 6) * (1/sample_freq_hz)
                                 = ((4656/2) / 6) * (1/44100) = 0.0088 sec = 8.8ms
```

8.8ms isn't bad; nice!

Can you confirm if `sample_freq_hz` in the above example should be 96,000, 44,100, or something else? And also that the rest of the math seems sound?

har-in-air, 2023-12-25:
You didn't miss it, I just appended the note now :-).
If you have configured Windows/Ubuntu/Android as per the documentation, the host will always resample the audio playback to 24bits @ 96kHz.  So you should use 96kHz for the latency calculation.

In any case just look at the LED feedback, and use the actual sample rate being used (44.1, 48 or 96 kHz) for calculating latency. Note that I have no idea about any other sources of latency (USB host drivers etc).

Closed 2024-08-21.

Thread 21 (2023-12-25):

Add a license to the project, please

DeflateAwning, 2023-12-25:
Can you please add a license? I'm hoping to make some changes, but would need confirmation that it's fair-game to modify and use in a project. Thanks!

MIT License is a good one, which is preferable, but any other open source one would be fine.

https://choosealicense.com/ is a great resource, if you have trouble picking one!

har-in-air, 2023-12-25:
I've used a snapshot of the STM32 HAL source code, so you can assume whatever licensing is mentioned in the header files under stm32_usb directory.

DeflateAwning, 2023-12-25:
The license used on the STM32 HAL code is a proprietary one of their own, which prevents redistribution in a lot of ways. It is barely an open source licence, and appears to only explicitly permit distribution as "a binary run on an STM32 device".

It would be great if you could add a real open source licence to this project. It might not mean much to you, but it's important for use of this project in general.

Closed 2023-12-25.

Thread 22 (2023-12-25):

Do you think this project could be made to use the internal clocks on the microcontroller?

DeflateAwning, 2023-12-25:
I'm working on a PCB for this project, and I'm trying to make it as small as possible. Any thoughts on the ability to use the internal clock on the STM32F411 instead of the external crystal clocks on the Black Pill dev kit?

har-in-air, 2023-12-27:
I don't have Stm32CubeIDE installed on my laptop right now, you can open the graphical dialog showing clock configuration and see if  the usb peripheral clock can be generated from the internal RC clock.  The internal RC clock in microcontrollers is usually not accurate or stable enough for reliable USB operation.  I don't remember seeing any datasheet  or app note suggesting that it would be OK. If it was possible, they would definitely have made a big deal of it.

DeflateAwning, 2023-12-27:
I don't see an IOC file in the repo, which is normally what allows you to use the GUI to look at clock/pin/peripheral configurations. Is there another way you know of?

I'm sure you're right though

har-in-air, 2023-12-28:
It's a makefile project that supports two different cpus. With STM32CubeIDE you can  create a new dummy project for the specific 401 or 411 device and then check out the clock configuration tab.

Closed 2023-12-28.

Thread 23 (2024-01-30):

I need your help please

cavl3108, 2024-01-30:
hola, que posibilidad hay de que me pueda ayudar a montar o desarrollar un codigo en base a este, asi sea necesario pagarle, es que necesito en base a la tarjeta black pill y la pcm5102, con el protocolo de audio usb crear una especie de crosover y ecualizador grafico digital donde haga uso del nucleo DSP integrado en la tarjeta y el control de las ganancias de bandas se realice por medio de una interfaz grafica ya sea digital por aplicacion en android o una interfaz analoga, porfavor necesito su ayuda.
Hello, what is the possibility that you can help me set up or develop a code based on this, even if it is necessary to pay you, I need, based on the black pill card and the pcm5102, with the USB audio protocol to create a kind of crossover and digital graphic equalizer where it makes use of the DSP core integrated into the card and the control of the band gains is carried out through a graphic interface, either digital through an Android application or an analog interface, please I need your help.

har-in-air, 2024-01-30:
Sorry, won't be able to help you with this. You should post on the facebook stm32 groups.

Sent from Yahoo Mail on Android

  On Tue, 30 Jan 2024 at 8:21 am, ***@***.***> wrote:

hola, que posibilidad hay de que me pueda ayudar a montar o desarrollar un codigo en base a este, asi sea necesario pagarle, es que necesito en base a la tarjeta black pill y la pcm5102, con el protocolo de audio usb crear una especie de crosover y ecualizador grafico digital donde haga uso del nucleo DSP integrado en la tarjeta y el control de las ganancias de bandas se realice por medio de una interfaz grafica ya sea digital por aplicacion en android o una interfaz analoga, porfavor necesito su ayuda.
Hello, what is the possibility that you can help me set up or develop a code based on this, even if it is necessary to pay you, I need, based on the black pill card and the pcm5102, with the USB audio protocol to create a kind of crossover and digital graphic equalizer where it makes use of the DSP core integrated into the card and the control of the band gains is carried out through a graphic interface, either digital through an Android application or an analog interface, please I need your help.

—
Reply to this email directly, view it on GitHub, or unsubscribe.
You are receiving this because you are subscribed to this thread.Message ID: ***@***.***>

Closed 2024-08-21.

Thread 24 (2024-06-15):

No sound on android phone

rudehardware, 2024-06-15:
Hi, I tried on 2phones, both phones recognized the usb device also configured as the picture from your android device but no sound at all. Working great on pc BTW.

har-in-air, 2024-06-16:
maybe your phone does not support hi-res usb audio (24bit 96khz)
    On Saturday 15 June, 2024 at 09:38:42 pm IST, rudehardware ***@***.***> wrote:

Hi, I tried on 2phones, both phones recognized the usb device also configured as the picture from your android device but no sound at all. Working great on pc BTW.

—
Reply to this email directly, view it on GitHub, or unsubscribe.
You are receiving this because you are subscribed to this thread.Message ID: ***@***.***>

har-in-air, 2024-06-16:
I've tested it with Poweramp app on two Samsung phones (Galaxy F62 and Galaxy F34), was last working about 6 months ago. Unfortunately  the PCM5102A module on my prototype boardwas damaged while trying to reseat it in the board socket, so am not able to confirm whether the Android updates since then have broken anything.
    On Saturday 15 June, 2024 at 09:38:42 pm IST, rudehardware ***@***.***> wrote:

Hi, I tried on 2phones, both phones recognized the usb device also configured as the picture from your android device but no sound at all. Working great on pc BTW.

—
Reply to this email directly, view it on GitHub, or unsubscribe.
You are receiving this because you are subscribed to this thread.Message ID: ***@***.***>

rudehardware, 2024-06-16:
im using samsung galaxy A71  android 13 security patch 1 august 23, after few hours figuring out finaly i found a  solution. i installed hiby music and turned on "enable HQ USB audio access" in the setting. dont know why poweramp doesnt work.
thanks for the great project

Closed 2024-06-21.

Thread 25 (2024-06-24):

blue led flashing and distorted sound

hellcat92, 2024-06-24:
Hi,
I am facing a weird issue where the blue led on the stm32 board is flashing rapidly and i am getting a distorted sound with continuous clicking noise. The sound is missing a lot of details and have a lower pitch. I tried on windows 11 and ubuntu 22.04, problem remains the same. I get same results on all sample rates, just the clicking frequency changes (higher on high samplerate).  Can you please take out some time to guide me in troubleshooting?
Thanks

har-in-air, 2024-06-24:
Try checking if the host  recognises the usb audio capabilities and is resampling the audio to  24bit @ 44.1, 48, or 96k (it should be 24 @ 96khz if you have optimised playback).  You can see the commands for checking the sound playback on Ubuntu, don't know what tools you can use on Windows.My PCM5102 module was damaged some months ago, so don't have a working setup myself.    On Monday 24 June, 2024 at 04:09:09 pm IST, hellcat92 ***@***.***> wrote:

Hi,
I am facing a weird issue where the blue led on the stm32 board is flashing rapidly and i am getting a distorted sound with continuous clicking noise. The sound is missing a lot of details and have a lower pitch. I tried on windows 11 and ubuntu 22.04, problem remains the same. I get same results on all sample rates, just the clicking frequency changes (higher on high samplerate). Can you please take out some time to guide me in troubleshooting?
Thanks

—
Reply to this email directly, view it on GitHub, or unsubscribe.
You are receiving this because you are subscribed to this thread.Message ID: ***@***.***>

har-in-air, 2024-06-29:
In case you are not using the black pill boards, check the crystal frequencies on your board.

litezxc, 2024-12-22:
how to add 32 bit?

Thread 26 (2024-06-26):

master clock frequency for 4 wire i2s

Jente105, 2024-06-26:
firstly, thanks for your work on this subject.
I was looking to replace the PCM5102a with a better dac. I noticed that the STM32F411xE configuration could provide the masterclock. what would the frequency of the masterclock be at the rated sample frequencies(44.1, 48 and 96 kHz) of your firmware when masterclock generation is enabled?

thanks,

har-in-air, 2024-06-27:
As per reference manual RM0383 for F411, when MCLK is enabled, MCLK = 256 x Fs (page 585)I've added a comment in the Makefile.
    On Wednesday 26 June, 2024 at 06:30:12 pm IST, Jente105 ***@***.***> wrote:

firstly, thanks for your work on this subject.
I was looking to replace the PCM5102a with a better dac. I noticed that the STM32F411xE configuration could provide the masterclock. what would the frequency of the masterclock be at the rated sample frequencies(44.1, 48 and 96 kHz) of your firmware when masterclock generation is enabled?

thanks,

—
Reply to this email directly, view it on GitHub, or unsubscribe.
You are receiving this because you are subscribed to this thread.Message ID: ***@***.***>

har-in-air, 2024-06-27:
My PCM5102A module died a few months ago (maybe ESD damage), so please add a link to your project when done, I might be tempted to try an upgrade myself.
    On Wednesday 26 June, 2024 at 06:30:12 pm IST, Jente105 ***@***.***> wrote:

firstly, thanks for your work on this subject.
I was looking to replace the PCM5102a with a better dac. I noticed that the STM32F411xE configuration could provide the masterclock. what would the frequency of the masterclock be at the rated sample frequencies(44.1, 48 and 96 kHz) of your firmware when masterclock generation is enabled?

thanks,

—
Reply to this email directly, view it on GitHub, or unsubscribe.
You are receiving this because you are subscribed to this thread.Message ID: ***@***.***>

Closed 2024-08-21.

Thread 27 (2024-08-18):

Can't make use of the last commit

TheMagicAlicorn, 2024-08-18:
Hey there,

Since the last and only release is quite old and doesn't reflect what's on the README, I decided to use the latest commit and for some reason I don't have any sound at the jack output.

I tried some debugging, nothing seems strange on the UART and my oscilloscope is showing I2S data in the DIN pin of the DAC. I even tired enabling the MCLK but no change.

Any idea what might be wrong ?
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

Thread 33 (2025-07-03):

im getting this issue pop_os

Omd5144, 2025-07-03:
omar@pop-os:~$ git clone https://github.com/kagurazakahope/STM32F401_USB_AUDIO_DAC
Cloning into 'STM32F401_USB_AUDIO_DAC'...
remote: Enumerating objects: 504, done.
remote: Counting objects: 100% (117/117), done.
remote: Compressing objects: 100% (19/19), done.
remote: Total 504 (delta 107), reused 98 (delta 98), pack-reused 387 (from 1)
Receiving objects: 100% (504/504), 3.27 MiB | 550.00 KiB/s, done.
Resolving deltas: 100% (219/219), done.
omar@pop-os:~$ cd STM32F401_USB_AUDIO_DAC
omar@pop-os:~/STM32F401_USB_AUDIO_DAC$ make clean
rm -fR build
omar@pop-os:~/STM32F401_USB_AUDIO_DAC$ make
mkdir build
arm-none-eabi-gcc -c -mcpu=cortex-m4 -mthumb -mfpu=fpv4-sp-d16 -mfloat-abi=hard -DUSE_HAL_DRIVER -DUSE_FULL_ASSERT -DSTM32F401xC  -DDEBUG_FEEDBACK_ENDPOINT  -Iinc -Idrivers/STM32F4xx_HAL_Driver/Inc -Idrivers/STM32F4xx_HAL_Driver/Inc/Legacy -Istm32_usb/Core/Inc -Istm32_usb/Class/AUDIO/Inc -Idrivers/CMSIS/Device/ST/STM32F4xx/Include -Idrivers/CMSIS/Include -Idrivers/BSP -O2 -Wall -fdata-sections -ffunction-sections -MMD -MP -MF"build/main.d" -Wa,-a,-ad,-alms=build/main.lst src/main.c -o build/main.o
arm-none-eabi-gcc -c -mcpu=cortex-m4 -mthumb -mfpu=fpv4-sp-d16 -mfloat-abi=hard -DUSE_HAL_DRIVER -DUSE_FULL_ASSERT -DSTM32F401xC  -DDEBUG_FEEDBACK_ENDPOINT  -Iinc -Idrivers/STM32F4xx_HAL_Driver/Inc -Idrivers/STM32F4xx_HAL_Driver/Inc/Legacy -Istm32_usb/Core/Inc -Istm32_usb/Class/AUDIO/Inc -Idrivers/CMSIS/Device/ST/STM32F4xx/Include -Idrivers/CMSIS/Include -Idrivers/BSP -O2 -Wall -fdata-sections -ffunction-sections -MMD -MP -MF"build/usart.d" -Wa,-a,-ad,-alms=build/usart.lst src/usart.c -o build/usart.o
arm-none-eabi-gcc -c -mcpu=cortex-m4 -mthumb -mfpu=fpv4-sp-d16 -mfloat-abi=hard -DUSE_HAL_DRIVER -DUSE_FULL_ASSERT -DSTM32F401xC  -DDEBUG_FEEDBACK_ENDPOINT  -Iinc -Idrivers/STM32F4xx_HAL_Driver/Inc -Idrivers/STM32F4xx_HAL_Driver/Inc/Legacy -Istm32_usb/Core/Inc -Istm32_usb/Class/AUDIO/Inc -Idrivers/CMSIS/Device/ST/STM32F4xx/Include -Idrivers/CMSIS/Include -Idrivers/BSP -O2 -Wall -fdata-sections -ffunction-sections -MMD -MP -MF"build/usbd_conf.d" -Wa,-a,-ad,-alms=build/usbd_conf.lst src/usbd_conf.c -o build/usbd_conf.o
arm-none-eabi-gcc -c -mcpu=cortex-m4 -mthumb -mfpu=fpv4-sp-d16 -mfloat-abi=hard -DUSE_HAL_DRIVER -DUSE_FULL_ASSERT -DSTM32F401xC  -DDEBUG_FEEDBACK_ENDPOINT  -Iinc -Idrivers/STM32F4xx_HAL_Driver/Inc -Idrivers/STM32F4xx_HAL_Driver/Inc/Legacy -Istm32_usb/Core/Inc -Istm32_usb/Class/AUDIO/Inc -Idrivers/CMSIS/Device/ST/STM32F4xx/Include -Idrivers/CMSIS/Include -Idrivers/BSP -O2 -Wall -fdata-sections -ffunction-sections -MMD -MP -MF"build/usbd_desc.d" -Wa,-a,-ad,-alms=build/usbd_desc.lst src/usbd_desc.c -o build/usbd_desc.o
arm-none-eabi-gcc -c -mcpu=cortex-m4 -mthumb -mfpu=fpv4-sp-d16 -mfloat-abi=hard -DUSE_HAL_DRIVER -DUSE_FULL_ASSERT -DSTM32F401xC  -DDEBUG_FEEDBACK_ENDPOINT  -Iinc -Idrivers/STM32F4xx_HAL_Driver/Inc -Idrivers/STM32F4xx_HAL_Driver/Inc/Legacy -Istm32_usb/Core/Inc -Istm32_usb/Class/AUDIO/Inc -Idrivers/CMSIS/Device/ST/STM32F4xx/Include -Idrivers/CMSIS/Include -Idrivers/BSP -O2 -Wall -fdata-sections -ffunction-sections -MMD -MP -MF"build/usbd_audio_if.d" -Wa,-a,-ad,-alms=build/usbd_audio_if.lst src/usbd_audio_if.c -o build/usbd_audio_if.o
arm-none-eabi-gcc -c -mcpu=cortex-m4 -mthumb -mfpu=fpv4-sp-d16 -mfloat-abi=hard -DUSE_HAL_DRIVER -DUSE_FULL_ASSERT -DSTM32F401xC  -DDEBUG_FEEDBACK_ENDPOINT  -Iinc -Idrivers/STM32F4xx_HAL_Driver/Inc -Idrivers/STM32F4xx_HAL_Driver/Inc/Legacy -Istm32_usb/Core/Inc -Istm32_usb/Class/AUDIO/Inc -Idrivers/CMSIS/Device/ST/STM32F4xx/Include -Idrivers/CMSIS/Include -Idrivers/BSP -O2 -Wall -fdata-sections -ffunction-sections -MMD -MP -MF"build/stm32f4xx_it.d" -Wa,-a,-ad,-alms=build/stm32f4xx_it.lst src/stm32f4xx_it.c -o build/stm32f4xx_it.o
arm-none-eabi-gcc -c -mcpu=cortex-m4 -mthumb -mfpu=fpv4-sp-d16 -mfloat-abi=hard -DUSE_HAL_DRIVER -DUSE_FULL_ASSERT -DSTM32F401xC  -DDEBUG_FEEDBACK_ENDPOINT  -Iinc -Idrivers/STM32F4xx_HAL_Driver/Inc -Idrivers/STM32F4xx_HAL_Driver/Inc/Legacy -Istm32_usb/Core/Inc -Istm32_usb/Class/AUDIO/Inc -Idrivers/CMSIS/Device/ST/STM32F4xx/Include -Idrivers/CMSIS/Include -Idrivers/BSP -O2 -Wall -fdata-sections -ffunction-sections -MMD -MP -MF"build/stm32f4xx_hal_pcd.d" -Wa,-a,-ad,-alms=build/stm32f4xx_hal_pcd.lst drivers/STM32F4xx_HAL_Driver/Src/stm32f4xx_hal_pcd.c -o build/stm32f4xx_hal_pcd.o
arm-none-eabi-gcc -c -mcpu=cortex-m4 -mthumb -mfpu=fpv4-sp-d16 -mfloat-abi=hard -DUSE_HAL_DRIVER -DUSE_FULL_ASSERT -DSTM32F401xC  -DDEBUG_FEEDBACK_ENDPOINT  -Iinc -Idrivers/STM32F4xx_HAL_Driver/Inc -Idrivers/STM32F4xx_HAL_Driver/Inc/Legacy -Istm32_usb/Core/Inc -Istm32_usb/Class/AUDIO/Inc -Idrivers/CMSIS/Device/ST/STM32F4xx/Include -Idrivers/CMSIS/Include -Idrivers/BSP -O2 -Wall -fdata-sections -ffunction-sections -MMD -MP -MF"build/stm32f4xx_hal_pcd_ex.d" -Wa,-a,-ad,-alms=build/stm32f4xx_hal_pcd_ex.lst drivers/STM32F4xx_HAL_Driver/Src/stm32f4xx_hal_pcd_ex.c -o build/stm32f4xx_hal_pcd_ex.o
arm-none-eabi-gcc -c -mcpu=cortex-m4 -mthumb -mfpu=fpv4-sp-d16 -mfloat-abi=hard -DUSE_HAL_DRIVER -DUSE_FULL_ASSERT -DSTM32F401xC  -DDEBUG_FEEDBACK_ENDPOINT  -Iinc -Idrivers/STM32F4xx_HAL_Driver/Inc -Idrivers/STM32F4xx_HAL_Driver/Inc/Legacy -Istm32_usb/Core/Inc -Istm32_usb/Class/AUDIO/Inc -Idrivers/CMSIS/Device/ST/STM32F4xx/Include -Idrivers/CMSIS/Include -Idrivers/BSP -O2 -Wall -fdata-sections -ffunction-sections -MMD -MP -MF"build/stm32f4xx_ll_usb.d" -Wa,-a,-ad,-alms=build/stm32f4xx_ll_usb.lst drivers/STM32F4xx_HAL_Driver/Src/stm32f4xx_ll_usb.c -o build/stm32f4xx_ll_usb.o
arm-none-eabi-gcc -c -mcpu=cortex-m4 -mthumb -mfpu=fpv4-sp-d16 -mfloat-abi=hard -DUSE_HAL_DRIVER -DUSE_FULL_ASSERT -DSTM32F401xC  -DDEBUG_FEEDBACK_ENDPOINT  -Iinc -Idrivers/STM32F4xx_HAL_Driver/Inc -Idrivers/STM32F4xx_HAL_Driver/Inc/Legacy -Istm32_usb/Core/Inc -Istm32_usb/Class/AUDIO/Inc -Idrivers/CMSIS/Device/ST/STM32F4xx/Include -Idrivers/CMSIS/Include -Idrivers/BSP -O2 -Wall -fdata-sections -ffunction-sections -MMD -MP -MF"build/stm32f4xx_hal_i2s.d" -Wa,-a,-ad,-alms=build/stm32f4xx_hal_i2s.lst drivers/STM32F4xx_HAL_Driver/Src/stm32f4xx_hal_i2s.c -o build/stm32f4xx_hal_i2s.o
arm-none-eabi-gcc -c -mcpu=cortex-m4 -mthumb -mfpu=fpv4-sp-d16 -mfloat-abi=hard -DUSE_HAL_DRIVER -DUSE_FULL_ASSERT -DSTM32F401xC  -DDEBUG_FEEDBACK_ENDPOINT  -Iinc -Idrivers/STM32F4xx_HAL_Driver/Inc -Idrivers/STM32F4xx_HAL_Driver/Inc/Legacy -Istm32_usb/Core/Inc -Istm32_usb/Class/AUDIO/Inc -Idrivers/CMSIS/Device/ST/STM32F4xx/Include -Idrivers/CMSIS/Include -Idrivers/BSP -O2 -Wall -fdata-sections -ffunction-sections -MMD -MP -MF"build/stm32f4xx_hal_i2s_ex.d" -Wa,-a,-ad,-alms=build/stm32f4xx_hal_i2s_ex.lst drivers/STM32F4xx_HAL_Driver/Src/stm32f4xx_hal_i2s_ex.c -o build/stm32f4xx_hal_i2s_ex.o
arm-none-eabi-gcc -c -mcpu=cortex-m4 -mthumb -mfpu=fpv4-sp-d16 -mfloat-abi=hard -DUSE_HAL_DRIVER -DUSE_FULL_ASSERT -DSTM32F401xC  -DDEBUG_FEEDBACK_ENDPOINT  -Iinc -Idrivers/STM32F4xx_HAL_Driver/Inc -Idrivers/STM32F4xx_HAL_Driver/Inc/Legacy -Istm32_usb/Core/Inc -Istm32_usb/Class/AUDIO/Inc -Idrivers/CMSIS/Device/ST/STM32F4xx/Include -Idrivers/CMSIS/Include -Idrivers/BSP -O2 -Wall -fdata-sections -ffunction-sections -MMD -MP -MF"build/stm32f4xx_hal_tim.d" -Wa,-a,-ad,-alms=build/stm32f4xx_hal_tim.lst drivers/STM32F4xx_HAL_Driver/Src/stm32f4xx_hal_tim.c -o build/stm32f4xx_hal_tim.o
arm-none-eabi-gcc -c -mcpu=cortex-m4 -mthumb -mfpu=fpv4-sp-d16 -mfloat-abi=hard -DUSE_HAL_DRIVER -DUSE_FULL_ASSERT -DSTM32F401xC  -DDEBUG_FEEDBACK_ENDPOINT  -Iinc -Idrivers/STM32F4xx_HAL_Driver/Inc -Idrivers/STM32F4xx_HAL_Driver/Inc/Legacy -Istm32_usb/Core/Inc -Istm32_usb/Class/AUDIO/Inc -Idrivers/CMSIS/Device/ST/STM32F4xx/Include -Idrivers/CMSIS/Include -Idrivers/BSP -O2 -Wall -fdata-sections -ffunction-sections -MMD -MP -MF"build/stm32f4xx_hal_tim_ex.d" -Wa,-a,-ad,-alms=build/stm32f4xx_hal_tim_ex.lst drivers/STM32F4xx_HAL_Driver/Src/stm32f4xx_hal_tim_ex.c -o build/stm32f4xx_hal_tim_ex.o
arm-none-eabi-gcc -c -mcpu=cortex-m4 -mthumb -mfpu=fpv4-sp-d16 -mfloat-abi=hard -DUSE_HAL_DRIVER -DUSE_FULL_ASSERT -DSTM32F401xC  -DDEBUG_FEEDBACK_ENDPOINT  -Iinc -Idrivers/STM32F4xx_HAL_Driver/Inc -Idrivers/STM32F4xx_HAL_Driver/Inc/Legacy -Istm32_usb/Core/Inc -Istm32_usb/Class/AUDIO/Inc -Idrivers/CMSIS/Device/ST/STM32F4xx/Include -Idrivers/CMSIS/Include -Idrivers/BSP -O2 -Wall -fdata-sections -ffunction-sections -MMD -MP -MF"build/stm32f4xx_hal_rcc.d" -Wa,-a,-ad,-alms=build/stm32f4xx_hal_rcc.lst drivers/STM32F4xx_HAL_Driver/Src/stm32f4xx_hal_rcc.c -o build/stm32f4xx_hal_rcc.o
arm-none-eabi-gcc -c -mcpu=cortex-m4 -mthumb -mfpu=fpv4-sp-d16 -mfloat-abi=hard -DUSE_HAL_DRIVER -DUSE_FULL_ASSERT -DSTM32F401xC  -DDEBUG_FEEDBACK_ENDPOINT  -Iinc -Idrivers/STM32F4xx_HAL_Driver/Inc -Idrivers/STM32F4xx_HAL_Driver/Inc/Legacy -Istm32_usb/Core/Inc -Istm32_usb/Class/AUDIO/Inc -Idrivers/CMSIS/Device/ST/STM32F4xx/Include -Idrivers/CMSIS/Include -Idrivers/BSP -O2 -Wall -fdata-sections -ffunction-sections -MMD -MP -MF"build/stm32f4xx_hal_rcc_ex.d" -Wa,-a,-ad,-alms=build/stm32f4xx_hal_rcc_ex.lst drivers/STM32F4xx_HAL_Driver/Src/stm32f4xx_hal_rcc_ex.c -o build/stm32f4xx_hal_rcc_ex.o
arm-none-eabi-gcc -c -mcpu=cortex-m4 -mthumb -mfpu=fpv4-sp-d16 -mfloat-abi=hard -DUSE_HAL_DRIVER -DUSE_FULL_ASSERT -DSTM32F401xC  -DDEBUG_FEEDBACK_ENDPOINT  -Iinc -Idrivers/STM32F4xx_HAL_Driver/Inc -Idrivers/STM32F4xx_HAL_Driver/Inc/Legacy -Istm32_usb/Core/Inc -Istm32_usb/Class/AUDIO/Inc -Idrivers/CMSIS/Device/ST/STM32F4xx/Include -Idrivers/CMSIS/Include -Idrivers/BSP -O2 -Wall -fdata-sections -ffunction-sections -MMD -MP -MF"build/stm32f4xx_hal_flash.d" -Wa,-a,-ad,-alms=build/stm32f4xx_hal_flash.lst drivers/STM32F4xx_HAL_Driver/Src/stm32f4xx_hal_flash.c -o build/stm32f4xx_hal_flash.o
arm-none-eabi-gcc -c -mcpu=cortex-m4 -mthumb -mfpu=fpv4-sp-d16 -mfloat-abi=hard -DUSE_HAL_DRIVER -DUSE_FULL_ASSERT -DSTM32F401xC  -DDEBUG_FEEDBACK_ENDPOINT  -Iinc -Idrivers/STM32F4xx_HAL_Driver/Inc -Idrivers/STM32F4xx_HAL_Driver/Inc/Legacy -Istm32_usb/Core/Inc -Istm32_usb/Class/AUDIO/Inc -Idrivers/CMSIS/Device/ST/STM32F4xx/Include -Idrivers/CMSIS/Include -Idrivers/BSP -O2 -Wall -fdata-sections -ffunction-sections -MMD -MP -MF"build/stm32f4xx_hal_flash_ex.d" -Wa,-a,-ad,-alms=build/stm32f4xx_hal_flash_ex.lst drivers/STM32F4xx_HAL_Driver/Src/stm32f4xx_hal_flash_ex.c -o build/stm32f4xx_hal_flash_ex.o
arm-none-eabi-gcc -c -mcpu=cortex-m4 -mthumb -mfpu=fpv4-sp-d16 -mfloat-abi=hard -DUSE_HAL_DRIVER -DUSE_FULL_ASSERT -DSTM32F401xC  -DDEBUG_FEEDBACK_ENDPOINT  -Iinc -Idrivers/STM32F4xx_HAL_Driver/Inc -Idrivers/STM32F4xx_HAL_Driver/Inc/Legacy -Istm32_usb/Core/Inc -Istm32_usb/Class/AUDIO/Inc -Idrivers/CMSIS/Device/ST/STM32F4xx/Include -Idrivers/CMSIS/Include -Idrivers/BSP -O2 -Wall -fdata-sections -ffunction-sections -MMD -MP -MF"build/stm32f4xx_hal_flash_ramfunc.d" -Wa,-a,-ad,-alms=build/stm32f4xx_hal_flash_ramfunc.lst drivers/STM32F4xx_HAL_Driver/Src/stm32f4xx_hal_flash_ramfunc.c -o build/stm32f4xx_hal_flash_ramfunc.o
arm-none-eabi-gcc -c -mcpu=cortex-m4 -mthumb -mfpu=fpv4-sp-d16 -mfloat-abi=hard -DUSE_HAL_DRIVER -DUSE_FULL_ASSERT -DSTM32F401xC  -DDEBUG_FEEDBACK_ENDPOINT  -Iinc -Idrivers/STM32F4xx_HAL_Driver/Inc -Idrivers/STM32F4xx_HAL_Driver/Inc/Legacy -Istm32_usb/Core/Inc -Istm32_usb/Class/AUDIO/Inc -Idrivers/CMSIS/Device/ST/STM32F4xx/Include -Idrivers/CMSIS/Include -Idrivers/BSP -O2 -Wall -fdata-sections -ffunction-sections -MMD -MP -MF"build/stm32f4xx_hal_gpio.d" -Wa,-a,-ad,-alms=build/stm32f4xx_hal_gpio.lst drivers/STM32F4xx_HAL_Driver/Src/stm32f4xx_hal_gpio.c -o build/stm32f4xx_hal_gpio.o
arm-none-eabi-gcc -c -mcpu=cortex-m4 -mthumb -mfpu=fpv4-sp-d16 -mfloat-abi=hard -DUSE_HAL_DRIVER -DUSE_FULL_ASSERT -DSTM32F401xC  -DDEBUG_FEEDBACK_ENDPOINT  -Iinc -Idrivers/STM32F4xx_HAL_Driver/Inc -Idrivers/STM32F4xx_HAL_Driver/Inc/Legacy -Istm32_usb/Core/Inc -Istm32_usb/Class/AUDIO/Inc -Idrivers/CMSIS/Device/ST/STM32F4xx/Include -Idrivers/CMSIS/Include -Idrivers/BSP -O2 -Wall -fdata-sections -ffunction-sections -MMD -MP -MF"build/stm32f4xx_hal_dma_ex.d" -Wa,-a,-ad,-alms=build/stm32f4xx_hal_dma_ex.lst drivers/STM32F4xx_HAL_Driver/Src/stm32f4xx_hal_dma_ex.c -o build/stm32f4xx_hal_dma_ex.o
arm-none-eabi-gcc -c -mcpu=cortex-m4 -mthumb -mfpu=fpv4-sp-d16 -mfloat-abi=hard -DUSE_HAL_DRIVER -DUSE_FULL_ASSERT -DSTM32F401xC  -DDEBUG_FEEDBACK_ENDPOINT  -Iinc -Idrivers/STM32F4xx_HAL_Driver/Inc -Idrivers/STM32F4xx_HAL_Driver/Inc/Legacy -Istm32_usb/Core/Inc -Istm32_usb/Class/AUDIO/Inc -Idrivers/CMSIS/Device/ST/STM32F4xx/Include -Idrivers/CMSIS/Include -Idrivers/BSP -O2 -Wall -fdata-sections -ffunction-sections -MMD -MP -MF"build/stm32f4xx_hal_dma.d" -Wa,-a,-ad,-alms=build/stm32f4xx_hal_dma.lst drivers/STM32F4xx_HAL_Driver/Src/stm32f4xx_hal_dma.c -o build/stm32f4xx_hal_dma.o
arm-none-eabi-gcc -c -mcpu=cortex-m4 -mthumb -mfpu=fpv4-sp-d16 -mfloat-abi=hard -DUSE_HAL_DRIVER -DUSE_FULL_ASSERT -DSTM32F401xC  -DDEBUG_FEEDBACK_ENDPOINT  -Iinc -Idrivers/STM32F4xx_HAL_Driver/Inc -Idrivers/STM32F4xx_HAL_Driver/Inc/Legacy -Istm32_usb/Core/Inc -Istm32_usb/Class/AUDIO/Inc -Idrivers/CMSIS/Device/ST/STM32F4xx/Include -Idrivers/CMSIS/Include -Idrivers/BSP -O2 -Wall -fdata-sections -ffunction-sections -MMD -MP -MF"build/stm32f4xx_hal_pwr.d" -Wa,-a,-ad,-alms=build/stm32f4xx_hal_pwr.lst drivers/STM32F4xx_HAL_Driver/Src/stm32f4xx_hal_pwr.c -o build/stm32f4xx_hal_pwr.o
arm-none-eabi-gcc -c -mcpu=cortex-m4 -mthumb -mfpu=fpv4-sp-d16 -mfloat-abi=hard -DUSE_HAL_DRIVER -DUSE_FULL_ASSERT -DSTM32F401xC  -DDEBUG_FEEDBACK_ENDPOINT  -Iinc -Idrivers/STM32F4xx_HAL_Driver/Inc -Idrivers/STM32F4xx_HAL_Driver/Inc/Legacy -Istm32_usb/Core/Inc -Istm32_usb/Class/AUDIO/Inc -Idrivers/CMSIS/Device/ST/STM32F4xx/Include -Idrivers/CMSIS/Include -Idrivers/BSP -O2 -Wall -fdata-sections -ffunction-sections -MMD -MP -MF"build/stm32f4xx_hal_uart.d" -Wa,-a,-ad,-alms=build/stm32f4xx_hal_uart.lst drivers/STM32F4xx_HAL_Driver/Src/stm32f4xx_hal_uart.c -o build/stm32f4xx_hal_uart.o
arm-none-eabi-gcc -c -mcpu=cortex-m4 -mthumb -mfpu=fpv4-sp-d16 -mfloat-abi=hard -DUSE_HAL_DRIVER -DUSE_FULL_ASSERT -DSTM32F401xC  -DDEBUG_FEEDBACK_ENDPOINT  -Iinc -Idrivers/STM32F4xx_HAL_Driver/Inc -Idrivers/STM32F4xx_HAL_Driver/Inc/Legacy -Istm32_usb/Core/Inc -Istm32_usb/Class/AUDIO/Inc -Idrivers/CMSIS/Device/ST/STM32F4xx/Include -Idrivers/CMSIS/Include -Idrivers/BSP -O2 -Wall -fdata-sections -ffunction-sections -MMD -MP -MF"build/stm32f4xx_hal_pwr_ex.d" -Wa,-a,-ad,-alms=build/stm32f4xx_hal_pwr_ex.lst drivers/STM32F4xx_HAL_Driver/Src/stm32f4xx_hal_pwr_ex.c -o build/stm32f4xx_hal_pwr_ex.o
arm-none-eabi-gcc -c -mcpu=cortex-m4 -mthumb -mfpu=fpv4-sp-d16 -mfloat-abi=hard -DUSE_HAL_DRIVER -DUSE_FULL_ASSERT -DSTM32F401xC  -DDEBUG_FEEDBACK_ENDPOINT  -Iinc -Idrivers/STM32F4xx_HAL_Driver/Inc -Idrivers/STM32F4xx_HAL_Driver/Inc/Legacy -Istm32_usb/Core/Inc -Istm32_usb/Class/AUDIO/Inc -Idrivers/CMSIS/Device/ST/STM32F4xx/Include -Idrivers/CMSIS/Include -Idrivers/BSP -O2 -Wall -fdata-sections -ffunction-sections -MMD -MP -MF"build/stm32f4xx_hal_cortex.d" -Wa,-a,-ad,-alms=build/stm32f4xx_hal_cortex.lst drivers/STM32F4xx_HAL_Driver/Src/stm32f4xx_hal_cortex.c -o build/stm32f4xx_hal_cortex.o
arm-none-eabi-gcc -c -mcpu=cortex-m4 -mthumb -mfpu=fpv4-sp-d16 -mfloat-abi=hard -DUSE_HAL_DRIVER -DUSE_FULL_ASSERT -DSTM32F401xC  -DDEBUG_FEEDBACK_ENDPOINT  -Iinc -Idrivers/STM32F4xx_HAL_Driver/Inc -Idrivers/STM32F4xx_HAL_Driver/Inc/Legacy -Istm32_usb/Core/Inc -Istm32_usb/Class/AUDIO/Inc -Idrivers/CMSIS/Device/ST/STM32F4xx/Include -Idrivers/CMSIS/Include -Idrivers/BSP -O2 -Wall -fdata-sections -ffunction-sections -MMD -MP -MF"build/stm32f4xx_hal.d" -Wa,-a,-ad,-alms=build/stm32f4xx_hal.lst drivers/STM32F4xx_HAL_Driver/Src/stm32f4xx_hal.c -o build/stm32f4xx_hal.o
arm-none-eabi-gcc -c -mcpu=cortex-m4 -mthumb -mfpu=fpv4-sp-d16 -mfloat-abi=hard -DUSE_HAL_DRIVER -DUSE_FULL_ASSERT -DSTM32F401xC  -DDEBUG_FEEDBACK_ENDPOINT  -Iinc -Idrivers/STM32F4xx_HAL_Driver/Inc -Idrivers/STM32F4xx_HAL_Driver/Inc/Legacy -Istm32_usb/Core/Inc -Istm32_usb/Class/AUDIO/Inc -Idrivers/CMSIS/Device/ST/STM32F4xx/Include -Idrivers/CMSIS/Include -Idrivers/BSP -O2 -Wall -fdata-sections -ffunction-sections -MMD -MP -MF"build/stm32f4xx_hal_exti.d" -Wa,-a,-ad,-alms=build/stm32f4xx_hal_exti.lst drivers/STM32F4xx_HAL_Driver/Src/stm32f4xx_hal_exti.c -o build/stm32f4xx_hal_exti.o
arm-none-eabi-gcc -c -mcpu=cortex-m4 -mthumb -mfpu=fpv4-sp-d16 -mfloat-abi=hard -DUSE_HAL_DRIVER -DUSE_FULL_ASSERT -DSTM32F401xC  -DDEBUG_FEEDBACK_ENDPOINT  -Iinc -Idrivers/STM32F4xx_HAL_Driver/Inc -Idrivers/STM32F4xx_HAL_Driver/Inc/Legacy -Istm32_usb/Core/Inc -Istm32_usb/Class/AUDIO/Inc -Idrivers/CMSIS/Device/ST/STM32F4xx/Include -Idrivers/CMSIS/Include -Idrivers/BSP -O2 -Wall -fdata-sections -ffunction-sections -MMD -MP -MF"build/bsp_misc.d" -Wa,-a,-ad,-alms=build/bsp_misc.lst drivers/BSP/bsp_misc.c -o build/bsp_misc.o
arm-none-eabi-gcc -c -mcpu=cortex-m4 -mthumb -mfpu=fpv4-sp-d16 -mfloat-abi=hard -DUSE_HAL_DRIVER -DUSE_FULL_ASSERT -DSTM32F401xC  -DDEBUG_FEEDBACK_ENDPOINT  -Iinc -Idrivers/STM32F4xx_HAL_Driver/Inc -Idrivers/STM32F4xx_HAL_Driver/Inc/Legacy -Istm32_usb/Core/Inc -Istm32_usb/Class/AUDIO/Inc -Idrivers/CMSIS/Device/ST/STM32F4xx/Include -Idrivers/CMSIS/Include -Idrivers/BSP -O2 -Wall -fdata-sections -ffunction-sections -MMD -MP -MF"build/bsp_audio.d" -Wa,-a,-ad,-alms=build/bsp_audio.lst drivers/BSP/bsp_audio.c -o build/bsp_audio.o
arm-none-eabi-gcc -c -mcpu=cortex-m4 -mthumb -mfpu=fpv4-sp-d16 -mfloat-abi=hard -DUSE_HAL_DRIVER -DUSE_FULL_ASSERT -DSTM32F401xC  -DDEBUG_FEEDBACK_ENDPOINT  -Iinc -Idrivers/STM32F4xx_HAL_Driver/Inc -Idrivers/STM32F4xx_HAL_Driver/Inc/Legacy -Istm32_usb/Core/Inc -Istm32_usb/Class/AUDIO/Inc -Idrivers/CMSIS/Device/ST/STM32F4xx/Include -Idrivers/CMSIS/Include -Idrivers/BSP -O2 -Wall -fdata-sections -ffunction-sections -MMD -MP -MF"build/system_stm32f4xx.d" -Wa,-a,-ad,-alms=build/system_stm32f4xx.lst src/system_stm32f4xx.c -o build/system_stm32f4xx.o
arm-none-eabi-gcc -c -mcpu=cortex-m4 -mthumb -mfpu=fpv4-sp-d16 -mfloat-abi=hard -DUSE_HAL_DRIVER -DUSE_FULL_ASSERT -DSTM32F401xC  -DDEBUG_FEEDBACK_ENDPOINT  -Iinc -Idrivers/STM32F4xx_HAL_Driver/Inc -Idrivers/STM32F4xx_HAL_Driver/Inc/Legacy -Istm32_usb/Core/Inc -Istm32_usb/Class/AUDIO/Inc -Idrivers/CMSIS/Device/ST/STM32F4xx/Include -Idrivers/CMSIS/Include -Idrivers/BSP -O2 -Wall -fdata-sections -ffunction-sections -MMD -MP -MF"build/usbd_core.d" -Wa,-a,-ad,-alms=build/usbd_core.lst stm32_usb/Core/Src/usbd_core.c -o build/usbd_core.o
arm-none-eabi-gcc -c -mcpu=cortex-m4 -mthumb -mfpu=fpv4-sp-d16 -mfloat-abi=hard -DUSE_HAL_DRIVER -DUSE_FULL_ASSERT -DSTM32F401xC  -DDEBUG_FEEDBACK_ENDPOINT  -Iinc -Idrivers/STM32F4xx_HAL_Driver/Inc -Idrivers/STM32F4xx_HAL_Driver/Inc/Legacy -Istm32_usb/Core/Inc -Istm32_usb/Class/AUDIO/Inc -Idrivers/CMSIS/Device/ST/STM32F4xx/Include -Idrivers/CMSIS/Include -Idrivers/BSP -O2 -Wall -fdata-sections -ffunction-sections -MMD -MP -MF"build/usbd_ctlreq.d" -Wa,-a,-ad,-alms=build/usbd_ctlreq.lst stm32_usb/Core/Src/usbd_ctlreq.c -o build/usbd_ctlreq.o
arm-none-eabi-gcc -c -mcpu=cortex-m4 -mthumb -mfpu=fpv4-sp-d16 -mfloat-abi=hard -DUSE_HAL_DRIVER -DUSE_FULL_ASSERT -DSTM32F401xC  -DDEBUG_FEEDBACK_ENDPOINT  -Iinc -Idrivers/STM32F4xx_HAL_Driver/Inc -Idrivers/STM32F4xx_HAL_Driver/Inc/Legacy -Istm32_usb/Core/Inc -Istm32_usb/Class/AUDIO/Inc -Idrivers/CMSIS/Device/ST/STM32F4xx/Include -Idrivers/CMSIS/Include -Idrivers/BSP -O2 -Wall -fdata-sections -ffunction-sections -MMD -MP -MF"build/usbd_ioreq.d" -Wa,-a,-ad,-alms=build/usbd_ioreq.lst stm32_usb/Core/Src/usbd_ioreq.c -o build/usbd_ioreq.o
arm-none-eabi-gcc -c -mcpu=cortex-m4 -mthumb -mfpu=fpv4-sp-d16 -mfloat-abi=hard -DUSE_HAL_DRIVER -DUSE_FULL_ASSERT -DSTM32F401xC  -DDEBUG_FEEDBACK_ENDPOINT  -Iinc -Idrivers/STM32F4xx_HAL_Driver/Inc -Idrivers/STM32F4xx_HAL_Driver/Inc/Legacy -Istm32_usb/Core/Inc -Istm32_usb/Class/AUDIO/Inc -Idrivers/CMSIS/Device/ST/STM32F4xx/Include -Idrivers/CMSIS/Include -Idrivers/BSP -O2 -Wall -fdata-sections -ffunction-sections -MMD -MP -MF"build/usbd_audio.d" -Wa,-a,-ad,-alms=build/usbd_audio.lst stm32_usb/Class/AUDIO/Src/usbd_audio.c -o build/usbd_audio.o
arm-none-eabi-gcc -x assembler-with-cpp -c -mcpu=cortex-m4 -mthumb -mfpu=fpv4-sp-d16 -mfloat-abi=hard -DUSE_HAL_DRIVER -DUSE_FULL_ASSERT -DSTM32F401xC  -DDEBUG_FEEDBACK_ENDPOINT  -Iinc -Idrivers/STM32F4xx_HAL_Driver/Inc -Idrivers/STM32F4xx_HAL_Driver/Inc/Legacy -Istm32_usb/Core/Inc -Istm32_usb/Class/AUDIO/Inc -Idrivers/CMSIS/Device/ST/STM32F4xx/Include -Idrivers/CMSIS/Include -Idrivers/BSP -O2 -Wall -fdata-sections -ffunction-sections -MMD -MP -MF"build/startup_stm32f401ccux.d" startup_stm32f401ccux.s -o build/startup_stm32f401ccux.o
arm-none-eabi-gcc build/main.o build/usart.o build/usbd_conf.o build/usbd_desc.o build/usbd_audio_if.o build/stm32f4xx_it.o build/stm32f4xx_hal_pcd.o build/stm32f4xx_hal_pcd_ex.o build/stm32f4xx_ll_usb.o build/stm32f4xx_hal_i2s.o build/stm32f4xx_hal_i2s_ex.o build/stm32f4xx_hal_tim.o build/stm32f4xx_hal_tim_ex.o build/stm32f4xx_hal_rcc.o build/stm32f4xx_hal_rcc_ex.o build/stm32f4xx_hal_flash.o build/stm32f4xx_hal_flash_ex.o build/stm32f4xx_hal_flash_ramfunc.o build/stm32f4xx_hal_gpio.o build/stm32f4xx_hal_dma_ex.o build/stm32f4xx_hal_dma.o build/stm32f4xx_hal_pwr.o build/stm32f4xx_hal_uart.o build/stm32f4xx_hal_pwr_ex.o build/stm32f4xx_hal_cortex.o build/stm32f4xx_hal.o build/stm32f4xx_hal_exti.o build/bsp_misc.o build/bsp_audio.o build/system_stm32f4xx.o build/usbd_core.o build/usbd_ctlreq.o build/usbd_ioreq.o build/usbd_audio.o build/startup_stm32f401ccux.o -mcpu=cortex-m4 -mthumb -mfpu=fpv4-sp-d16 -mfloat-abi=hard -specs=nano.specs  -u _printf_float -TSTM32F401CCUX_FLASH.ld  -lc -lm -lnosys  -Wl,-Map=build/usb_audio_i2s.map,--cref -Wl,--gc-sections -o build/usb_audio_i2s.elf
/usr/lib/gcc/arm-none-eabi/10.3.1/../../../arm-none-eabi/bin/ld: build/usart.o:(.bss.led_num_status+0x0): multiple definition of `led_num_status'; build/main.o:(.bss.led_num_status+0x0): first defined here
/usr/lib/gcc/arm-none-eabi/10.3.1/../../../arm-none-eabi/bin/ld: build/usart.o:(.bss.led_number_pins+0x0): multiple definition of `led_number_pins'; build/main.o:(.bss.led_number_pins+0x0): first defined here
/usr/lib/gcc/arm-none-eabi/10.3.1/../../../arm-none-eabi/bin/ld: build/usbd_conf.o:(.bss.led_num_status+0x0): multiple definition of `led_num_status'; build/main.o:(.bss.led_num_status+0x0): first defined here
/usr/lib/gcc/arm-none-eabi/10.3.1/../../../arm-none-eabi/bin/ld: build/usbd_conf.o:(.bss.led_number_pins+0x0): multiple definition of `led_number_pins'; build/main.o:(.bss.led_number_pins+0x0): first defined here
/usr/lib/gcc/arm-none-eabi/10.3.1/../../../arm-none-eabi/bin/ld: build/usbd_audio_if.o:(.bss.led_num_status+0x0): multiple definition of `led_num_status'; build/main.o:(.bss.led_num_status+0x0): first defined here
/usr/lib/gcc/arm-none-eabi/10.3.1/../../../arm-none-eabi/bin/ld: build/usbd_audio_if.o:(.bss.led_number_pins+0x0): multiple definition of `led_number_pins'; build/main.o:(.bss.led_number_pins+0x0): first defined here
/usr/lib/gcc/arm-none-eabi/10.3.1/../../../arm-none-eabi/bin/ld: build/stm32f4xx_it.o:(.bss.led_num_status+0x0): multiple definition of `led_num_status'; build/main.o:(.bss.led_num_status+0x0): first defined here
/usr/lib/gcc/arm-none-eabi/10.3.1/../../../arm-none-eabi/bin/ld: build/stm32f4xx_it.o:(.bss.led_number_pins+0x0): multiple definition of `led_number_pins'; build/main.o:(.bss.led_number_pins+0x0): first defined here
/usr/lib/gcc/arm-none-eabi/10.3.1/../../../arm-none-eabi/bin/ld: build/bsp_misc.o:(.data.led_num_status+0x0): multiple definition of `led_num_status'; build/main.o:(.bss.led_num_status+0x0): first defined here
/usr/lib/gcc/arm-none-eabi/10.3.1/../../../arm-none-eabi/bin/ld: build/bsp_misc.o:(.data.led_number_pins+0x0): multiple definition of `led_number_pins'; build/main.o:(.bss.led_number_pins+0x0): first defined here
/usr/lib/gcc/arm-none-eabi/10.3.1/../../../arm-none-eabi/bin/ld: build/bsp_audio.o:(.bss.led_num_status+0x0): multiple definition of `led_num_status'; build/main.o:(.bss.led_num_status+0x0): first defined here
/usr/lib/gcc/arm-none-eabi/10.3.1/../../../arm-none-eabi/bin/ld: build/bsp_audio.o:(.bss.led_number_pins+0x0): multiple definition of `led_number_pins'; build/main.o:(.bss.led_number_pins+0x0): first defined here
/usr/lib/gcc/arm-none-eabi/10.3.1/../../../arm-none-eabi/bin/ld: build/usbd_audio.o:(.bss.led_num_status+0x0): multiple definition of `led_num_status'; build/main.o:(.bss.led_num_status+0x0): first defined here
/usr/lib/gcc/arm-none-eabi/10.3.1/../../../arm-none-eabi/bin/ld: build/usbd_audio.o:(.bss.led_number_pins+0x0): multiple definition of `led_number_pins'; build/main.o:(.bss.led_number_pins+0x0): first defined here
collect2: error: ld returned 1 exit status
make: *** [Makefile:186: build/usb_audio_i2s.elf] Error 1

har-in-air, 2025-07-05:
Can't find the variable led_number_pins in the source or header files in the src or BSP directories, so I don't know what source code you are building.

Closed 2025-07-05.

Thread 34 (2025-07-26):

SUCCESS

aksumesh, 2025-07-26:
Dear Sir,
Happy to inform that I have built this project successfully with NAU8402 DAC, with MCLK output.
Sounds excellent.
I wish to know more about the code, to support 192KHz/24 bits.
Thank you,
Sumesh

har-in-air, 2025-07-27:
Ref the table of Fs frequencies and corresponding register settings in RM0383 documentation with MCLK output enabled, 192kHz is not possible. 
    On Saturday 26 July, 2025 at 09:13:13 am IST, aksumesh ***@***.***> wrote:

 aksumesh created an issue (har-in-air/STM32F411_USB_AUDIO_DAC#34)
Dear Sir,
Happy to inform that I have built this project successfully with NAU8402 DAC, with MCLK output.
Sounds excellent.
I wish to know more about the code, to support 192KHz/24 bits.
Thank you,
Sumesh

—
Reply to this email directly, view it on GitHub, or unsubscribe.
You are receiving this because you are subscribed to this thread.Message ID: ***@***.***>

aksumesh, 2025-07-29:
OK Sir,
Thank you!
Let me study.
Regards,
Sumesh

Thread 35 (2025-08-13):

Can't import source code to IDE

managerfriend, 2025-08-13:
Hello! Thank you for your work and publishing. I encountered some issue.
If i try import it the way you suggest in readme, ide says "No projects are found to import", if i try "projects from folder or archive", i get "project has no explicit encoding set' and it can't be built with error "Program file does not exist".
CubeIDE 1.19

har-in-air, 2025-08-14:
I haven't used CubeIDE in a while. I searched for "how to import a makefile project into STM32CubeIDE 1.19"  and got this result. Maybe you can try this.

Import Makefile into STM32CubeIDE
To import a Makefile project into STM32CubeIDE 1.19, follow these steps:

   -
Navigate to File > New > Makefile Project with Existing Code.

   -
In the "Project name" field, enter a name for your project.

   -
In the "Location" field, specify the path to the directory containing your existing Makefile and source code.

   -
Ensure the "Toolchain" is set to Cross GCC for ARM Cortex-M devices.

   -
Click Finish to create the project.

After the project is created, you must configure the MCU target for the build:

   -
Right-click on the project in the Project Explorer and select Properties.

   -
Navigate to C/C++ Build > Settings.

   -
Under the MCU Settings tab, select the correct MCU (e.g., STM32L072RBTX) from the list. This step is crucial for the debugger to function correctly.

Once the MCU is selected, you can create a debug configuration using the STM32 C/C++ Application debug type, which should now be available and functional. While the project can be compiled using the existing Makefile, debugging requires this MCU target configuration to be set within the project's build settings.
    On Wednesday 13 August, 2025 at 01:56:48 pm IST, managerfriend ***@***.***> wrote:

 managerfriend created an issue (har-in-air/STM32F411_USB_AUDIO_DAC#35)
Hello! Thank you for your work and publishing. I encountered some issue.
If i try import it the way you suggest in readme, ide says "No projects are found to import", if i try "projects from folder or archive", i get "project has no explicit encoding set' and it can't be built with error "Program file does not exist".
CubeIDE 1.19

—
Reply to this email directly, view it on GitHub, or unsubscribe.
You are receiving this because you are subscribed to this thread.Message ID: ***@***.***>
