har-in-air/STM32F411_USB_AUDIO_DAC/(commit log)

2020-11-29 use pid feedback
2020-12-13 move uart print to UART2
2021-01-12 change bsp pins for led and mute
2021-01-13 fix onboard led diagnostic, update readme
2021-03-20 support STM32F401CCU6
2021-05-02 fix PA0 KEY button interrupt
